Ichbinjoe/toaster-reflow/README.md

# Toaster Reflow

This board is a Raspberry Pi hat designed to be hooked up to a toaster oven to
reflow circuit boards. This board features:

+ AC Relay for turning on and off the toaster oven
+ Two thermocouple inputs
+ A servo connection for optional door servo
+ A buzzer for notifications
