Ichbinjoe/toaster-reflow/pt_1_5_2_5_0_h_cp.step

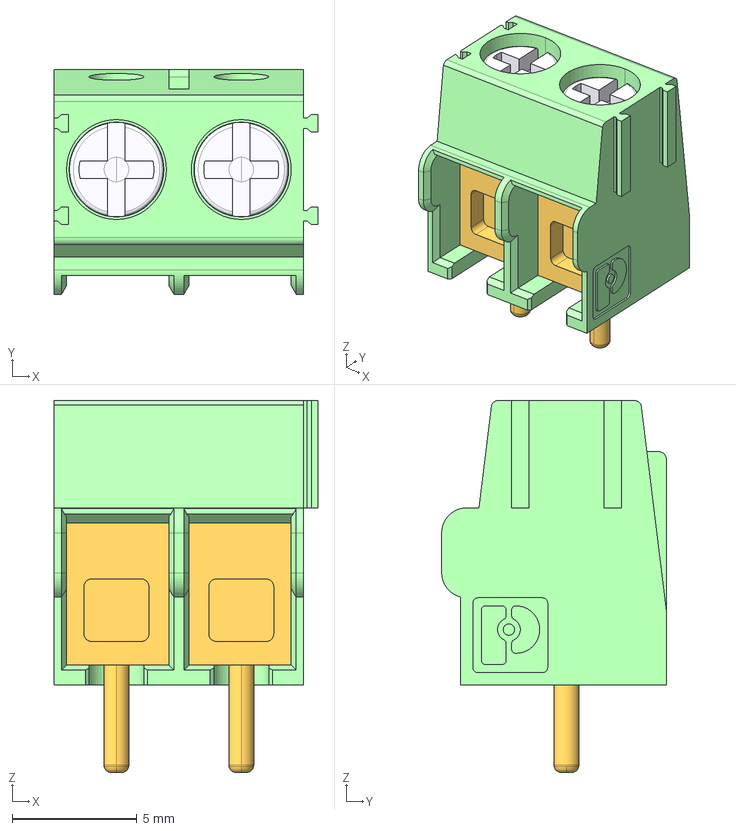
[picture p1: CAD file, 2018-09-21]
pt_1_5_2_5_0_h_cp.step
10.6 x 9.00 x 14.9 mm
