Ichbinjoe/toaster-reflow/PS12_Buzzer.step

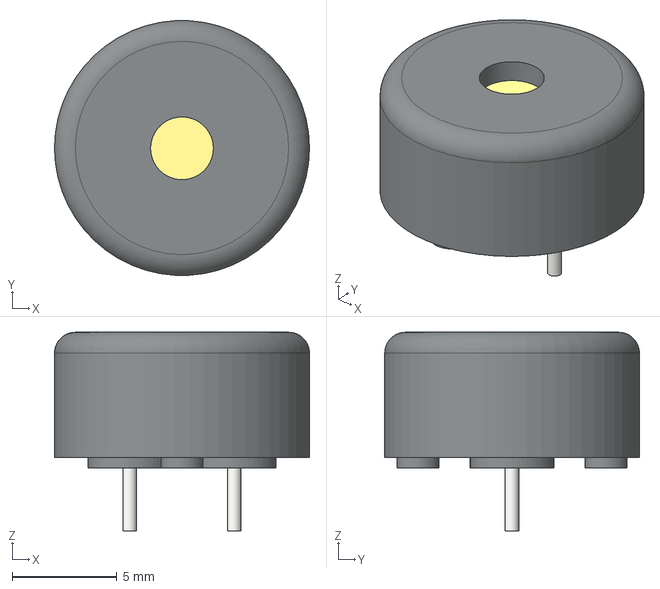
[picture p2: CAD file, 2018-09-21]
PS12_Buzzer.step
12.2 x 12.2 x 9.50 mm
