Ichbinjoe/toaster-reflow/ptsa_0_5_4_2_5_z_cp.step

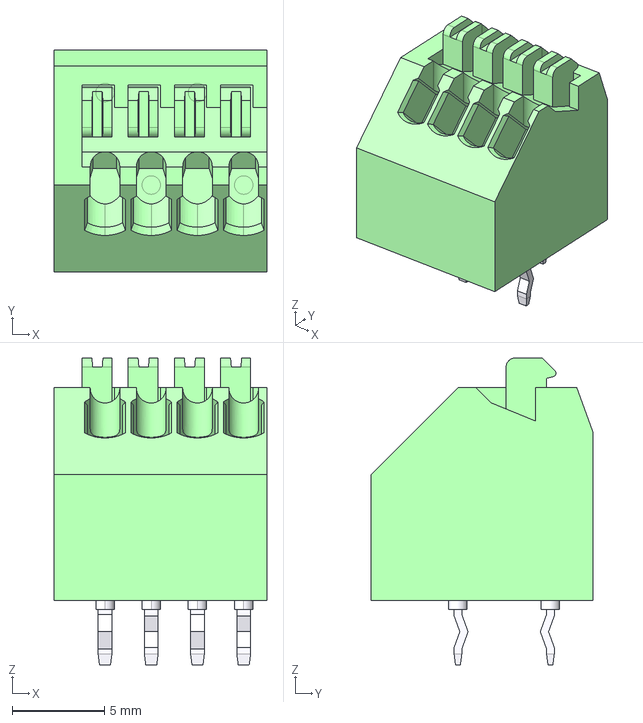
[picture p3: CAD file, 2018-09-21]
ptsa_0_5_4_2_5_z_cp.step
11.5 x 12.0 x 16.6 mm
