Ichbinjoe/toaster-reflow/C-1-1415899-3.step

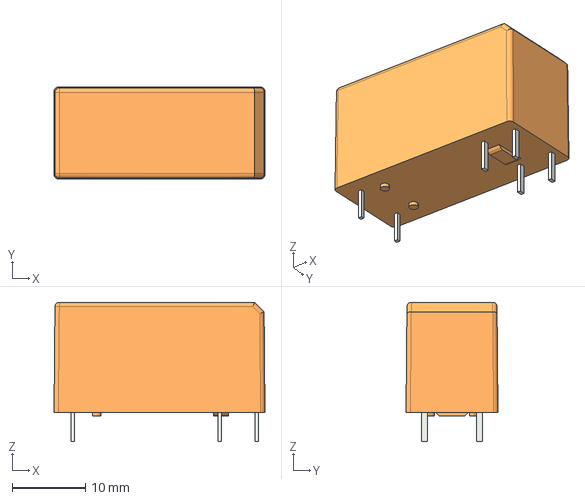
[picture p4: CAD file, 2018-09-21]
C-1-1415899-3.step
28.9 x 12.6 x 19.1 mm
