Ichbinjoe/toaster-reflow/toaster-reflow.kicad_pcb

## KiCad design toaster-reflow.kicad_pcb (2018-11-07)

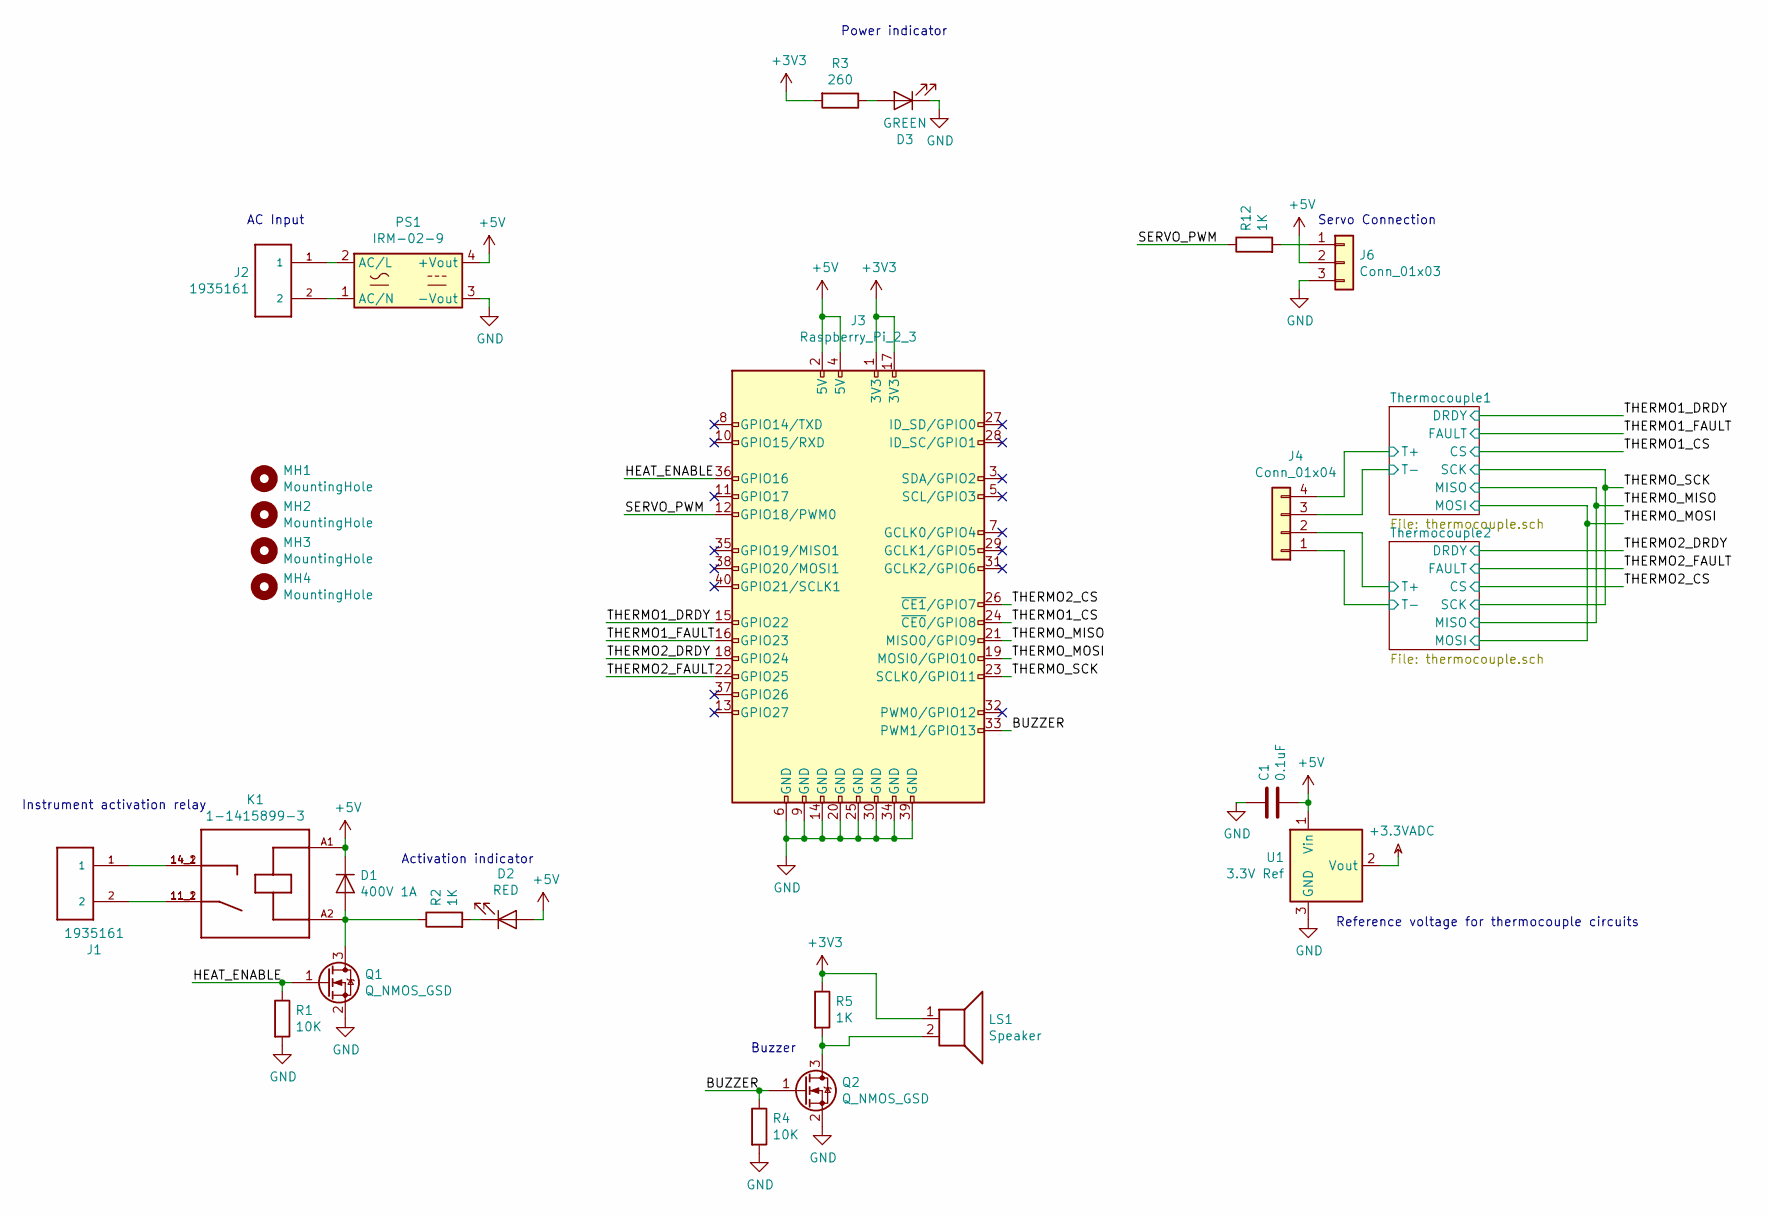
[picture p5: schematic toaster-reflow.sch]

Parts:
C1: 0.1uF; C_0603_1608Metric; DigikeyPartNumber 1276-1258-1-ND
D1: 400V 1A; D_SMA; DigikeyPartNumber 1655-1504-1-ND
D2: RED; D_0603_1608Metric; DigikeyPartNumber 732-4978-1-ND
D3: GREEN; D_0603_1608Metric; DigikeyPartNumber 732-4980-1-ND
J1, J2: 1935161; PHOENIX_1935161; DigikeyPartNumber 277-1667-ND
J3: Raspberry_Pi_2_3; PinHeader_2x20_P2.54mm_Vertical; DigikeyPartNumber S9200-ND
J4: Conn_01x04; 1990025; DigikeyPartNumber 277-1796-ND
J6: Conn_01x03; PinSocket_1x03_P2.54mm_Vertical; DigikeyPartNumber 732-5316-ND
K1: 1-1415899-3; RELAY_1-1415899-3; DigikeyPartNumber PB1267-ND
LS1: Speaker; PS12; DigikeyPartNumber 445-2525-1-ND
MH1, MH2, MH3, MH4: MountingHole; MountingHole_2.7mm_M2.5; DigikeyPartNumber 732-12923-ND
PS1: IRM-02-9; IRM-15-5; DigikeyPartNumber 1866-3037-ND
Q1, Q2: Q_NMOS_GSD; SC-59; DigikeyPartNumber RK7002BMT116CT-ND
R1, R4: 10K; R_0603_1608Metric; DigikeyPartNumber P10KGCT-ND
R2, R5, R12: 1K; R_0603_1608Metric; DigikeyPartNumber RHM1.0KDCT-ND
R3: 260; R_0603_1608Metric; DigikeyPartNumber P261HCT-ND
U1: 3.3V Ref; SOT-23; DigikeyPartNumber NCP51460SN33T1GOSCT-ND

Connections:
+3.3VADC: U1.2 (Vout); also elsewhere on the board
+3V3: J3.1 (3V3), J3.17 (3V3), LS1.1, R3.2, R5.1; also elsewhere on the board
+5V: C1.2, D1.1 (K), D2.2 (A), J3.2 (5V), J3.4 (5V), J6.2, K1.A1 (A2), PS1.4 (+Vout), U1.1 (Vin)
/BUZZER: J3.33 (PWM1/GPIO13), Q2.1 (G), R4.1
/HEAT_ENABLE: J3.36 (GPIO16), Q1.1 (G), R1.1
/SERVO_PWM: J3.12 (GPIO18/PWM0), R12.1
/THERMO1_CS: J3.24 (~CE0~/GPIO8); also elsewhere on the board
/THERMO1_DRDY: J3.15 (GPIO22); also elsewhere on the board
/THERMO1_FAULT: J3.16 (GPIO23); also elsewhere on the board
/THERMO2_CS: J3.26 (~CE1~/GPIO7); also elsewhere on the board
/THERMO2_DRDY: J3.18 (GPIO24); also elsewhere on the board
/THERMO2_FAULT: J3.22 (GPIO25); also elsewhere on the board
/THERMO_MISO: J3.21 (MISO0/GPIO9); also elsewhere on the board
/THERMO_MOSI: J3.19 (MOSI0/GPIO10); also elsewhere on the board
/THERMO_SCK: J3.23 (SCLK0/GPIO11); also elsewhere on the board
/Thermocouple1/T+: J4.4; also elsewhere on the board
/Thermocouple1/T-: J4.3; also elsewhere on the board
/Thermocouple2/T+: J4.2; also elsewhere on the board
/Thermocouple2/T-: J4.1; also elsewhere on the board
GND: C1.1, D3.1 (K), J3.6 (GND), J3.9 (GND), J3.14 (GND), J3.20 (GND), J3.25 (GND), J3.30 (GND), J3.34 (GND), J3.39 (GND), J6.3, PS1.3 (-Vout), Q1.2 (S), Q2.2 (S), R1.2, R4.2, U1.3 (GND); also elsewhere on the board
unnamed: D1.2 (A), K1.A2 (A1), Q1.3 (D), R2.1
unnamed: D2.1 (K), R2.2
unnamed: D3.2 (A), R3.1
unnamed: J1.1, K1.14_1 (14), K1.14_2 (14)
unnamed: J1.2, K1.11_1 (11), K1.11_2 (11)
unnamed: J2.1, PS1.2 (AC/L)
unnamed: J2.2, PS1.1 (AC/N)
unnamed: J6.1, R12.2
unnamed: LS1.2, Q2.3 (D), R5.2

Notes on the sheet:
Power indicator
Activation indicator
Instrument activation relay
Servo Connection
Reference voltage for thermocouple circuits
Buzzer
AC Input

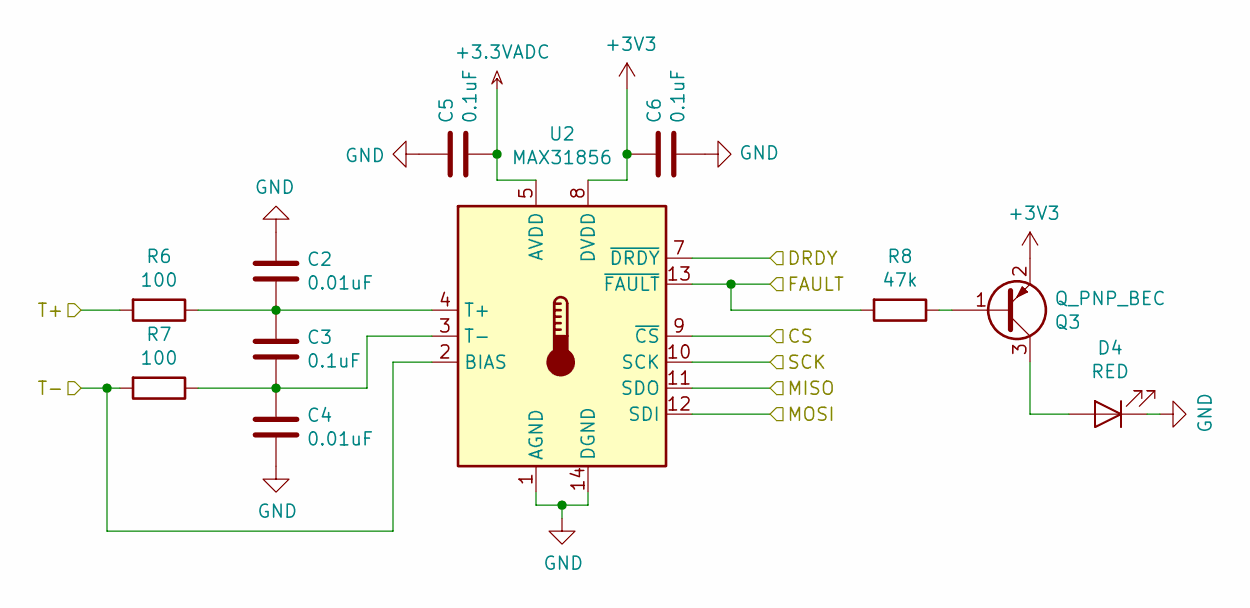
[picture p6: schematic thermocouple.sch]

Parts:
C2, C4: 0.01uF; C_0603_1608Metric; DigikeyPartNumber 1276-1921-1-ND
C3, C5, C6: 0.1uF; C_0603_1608Metric; DigikeyPartNumber 1276-1258-1-ND
D4: RED; D_0603_1608Metric; DigikeyPartNumber 732-4978-1-ND
Q3: Q_PNP_BEC; SC-59; DigikeyPartNumber MMBT3906-FDICT-ND
R6, R7: 100; R_0603_1608Metric; DigikeyPartNumber P100HCT-ND
R8: 47k; R_0603_1608Metric; DigikeyPartNumber P47.0KHCT-ND
U2: MAX31856; TSSOP-14_4.4x5mm_P0.65mm; DigikeyPartNumber MAX31856MUD+-ND

Connections:
+3.3VADC: C5.2, U2.5 (AVDD); also elsewhere on the board
+3V3: C6.1, Q3.2 (E), U2.8 (DVDD); also elsewhere on the board
/THERMO1_CS: U2.9 (~CS); also elsewhere on the board
/THERMO1_DRDY: U2.7 (~DRDY); also elsewhere on the board
/THERMO1_FAULT: R8.2, U2.13 (~FAULT); also elsewhere on the board
/THERMO_MISO: U2.11 (SDO); also elsewhere on the board
/THERMO_MOSI: U2.12 (SDI); also elsewhere on the board
/THERMO_SCK: U2.10 (SCK); also elsewhere on the board
/Thermocouple1/T+: R6.2; also elsewhere on the board
/Thermocouple1/T-: R7.2, U2.2 (BIAS); also elsewhere on the board
GND: C2.1, C4.2, C5.1, C6.2, D4.1 (K), U2.1 (AGND), U2.14 (DGND); also elsewhere on the board
unnamed: C2.2, C3.1, R6.1, U2.4 (T+)
unnamed: C3.2, C4.1, R7.1, U2.3 (T-)
unnamed: D4.2 (A), Q3.3 (C)
unnamed: Q3.1 (B), R8.1

Parts of its further copies:
C7, C9: 0.01uF; C_0603_1608Metric; DigikeyPartNumber 1276-1921-1-ND
C8, C10, C11: 0.1uF; C_0603_1608Metric; DigikeyPartNumber 1276-1258-1-ND
D5: RED; D_0603_1608Metric; DigikeyPartNumber 732-4978-1-ND
Q4: Q_PNP_BEC; SC-59; DigikeyPartNumber MMBT3906-FDICT-ND
R9, R10: 100; R_0603_1608Metric; DigikeyPartNumber P100HCT-ND
R11: 47k; R_0603_1608Metric; DigikeyPartNumber P47.0KHCT-ND
U3: MAX31856; TSSOP-14_4.4x5mm_P0.65mm; DigikeyPartNumber MAX31856MUD+-ND

Connections of its further copies:
+3.3VADC: C10.2, U3.5 (AVDD); also elsewhere on the board
+3V3: C11.1, Q4.2 (E), U3.8 (DVDD); also elsewhere on the board
/THERMO2_CS: U3.9 (~CS); also elsewhere on the board
/THERMO2_DRDY: U3.7 (~DRDY); also elsewhere on the board
/THERMO2_FAULT: R11.2, U3.13 (~FAULT); also elsewhere on the board
/THERMO_MISO: U3.11 (SDO); also elsewhere on the board
/THERMO_MOSI: U3.12 (SDI); also elsewhere on the board
/THERMO_SCK: U3.10 (SCK); also elsewhere on the board
/Thermocouple2/T+: R9.2; also elsewhere on the board
/Thermocouple2/T-: R10.2, U3.2 (BIAS); also elsewhere on the board
GND: C7.1, C9.2, C10.1, C11.2, D5.1 (K), U3.1 (AGND), U3.14 (DGND); also elsewhere on the board
unnamed: C7.2, C8.1, R9.1, U3.4 (T+)
unnamed: C8.2, C9.1, R10.1, U3.3 (T-)
unnamed: D5.2 (A), Q4.3 (C)
unnamed: Q4.1 (B), R11.1

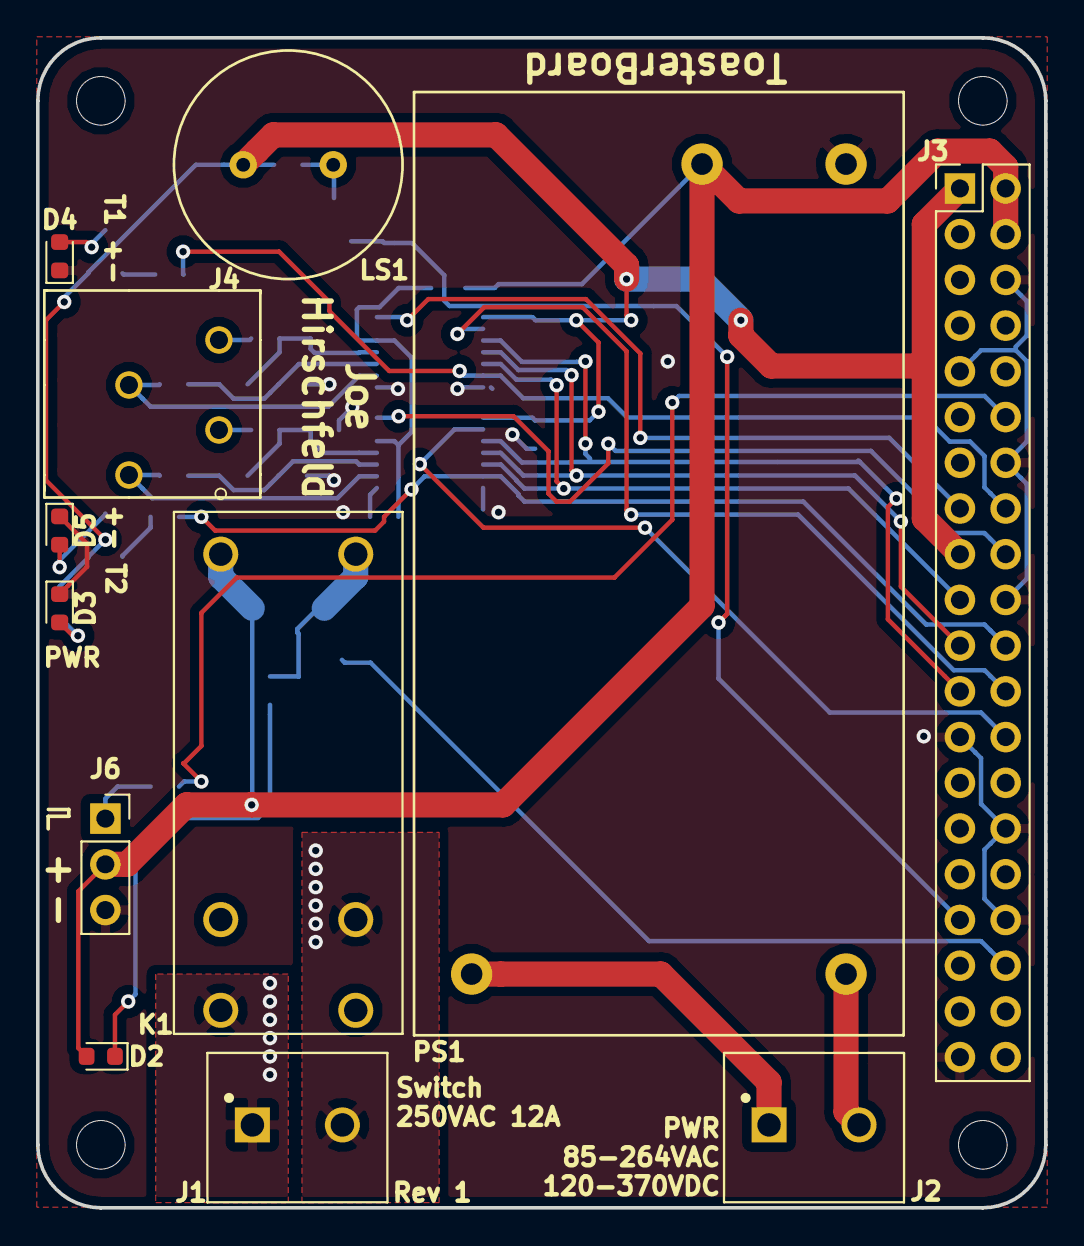
[picture p7: board toaster-reflow.kicad_pcb from above]

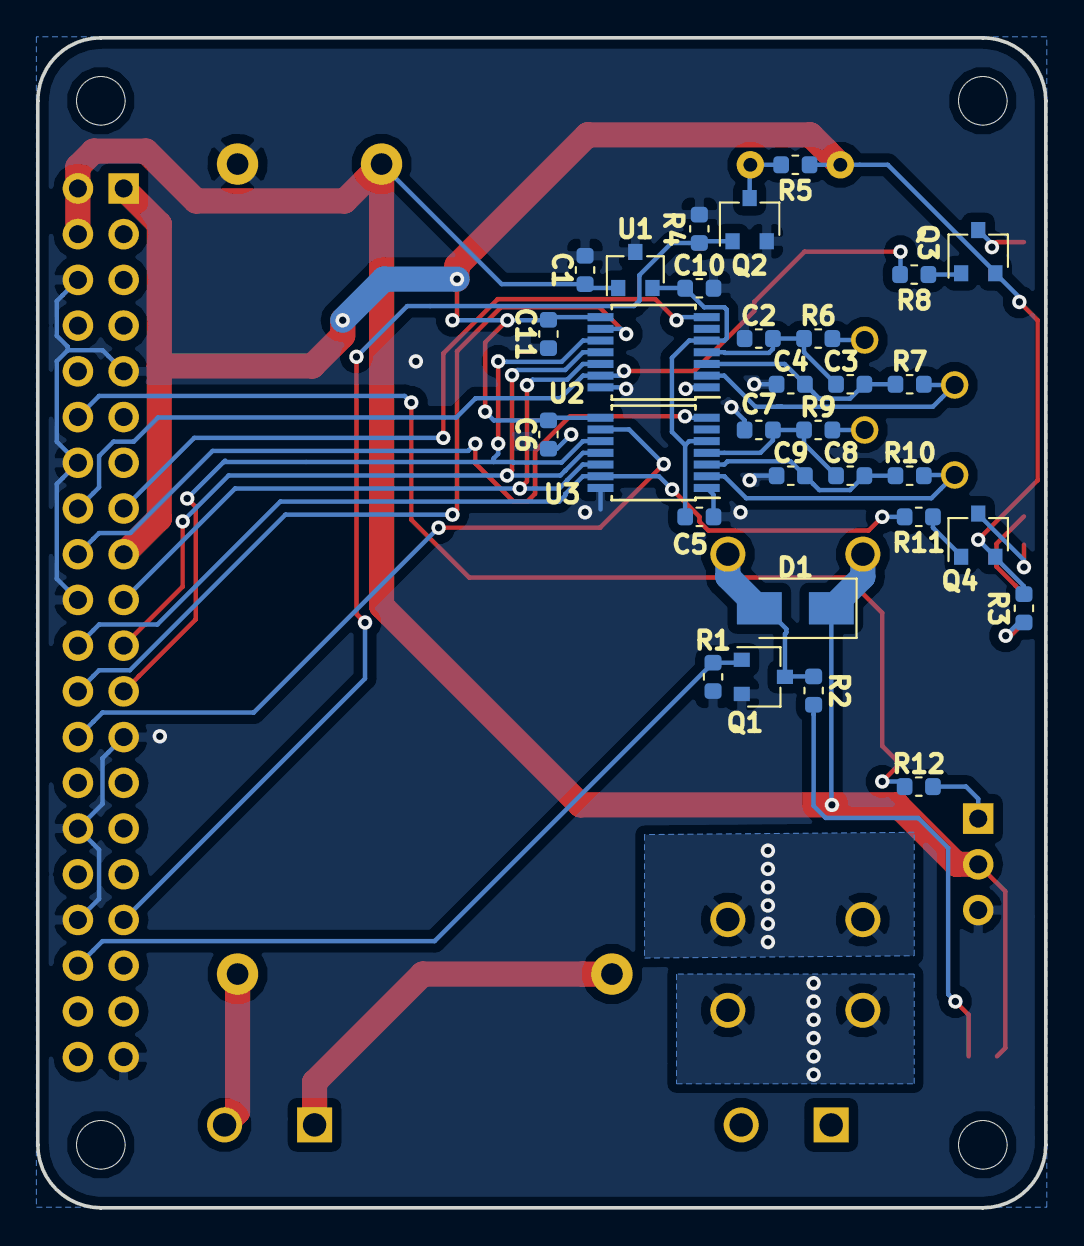
[picture p8: board toaster-reflow.kicad_pcb from below]

Board: 2 copper layers, 56.0 x 65.0 mm, 47 parts (31 on the bottom side), 37 nets.
