Ichbinjoe/toaster-reflow/toaster-reflowv1.kicad_pcb

## KiCad design toaster-reflowv1.kicad_pcb (2018-09-20)

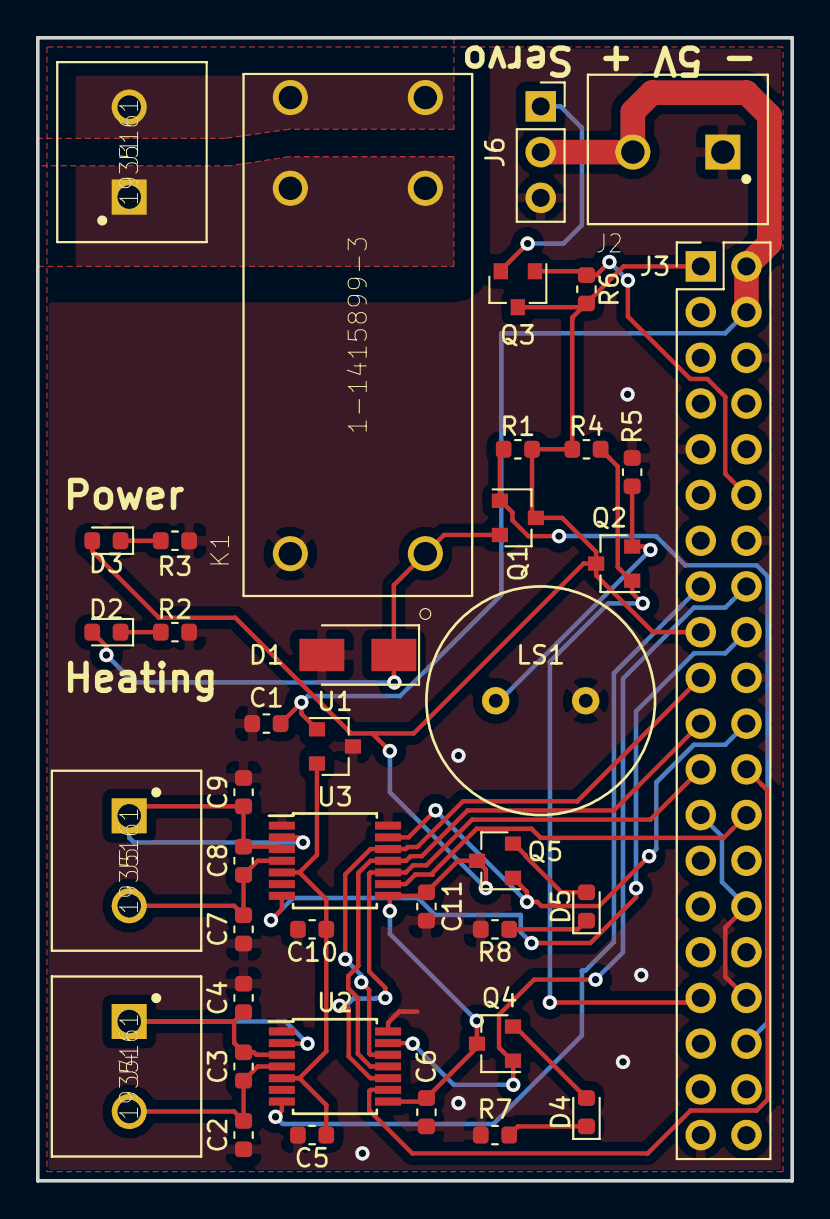
[picture p9: board toaster-reflowv1.kicad_pcb from above]

Board: 2 copper layers, 41.9 x 63.5 mm, 40 parts (0 on the bottom side), 31 nets.

Parts:
C1, C3, C5, C6, C8, C10, C11: 0.1uF; C_0603_1608Metric
C2, C4, C7, C9: 0.01uF; C_0603_1608Metric
D1: 400V 1A; D_SMA
D2, D4, D5: RED; D_0603_1608Metric
D3: GREEN; D_0603_1608Metric
J1, J2, J4, J5: 1935161; PHOENIX_1935161
J3: Raspberry_Pi_2_3; PinHeader_2x20_P2.54mm_Vertical
J6: Conn_01x03; PinSocket_1x03_P2.54mm_Vertical
K1: 1-1415899-3; RELAY_1-1415899-3
LS1: Speaker; PS12
Q1, Q2, Q3, Q4, Q5: Q_PMOS_GSD; SOT-23
R1, R4, R6: 10K; R_0603_1608Metric
R2, R7, R8: 470; R_0603_1608Metric
R3: 260; R_0603_1608Metric
R5: 1K; R_0603_1608Metric
U1: 3.3V Ref; SOT-23
U2, U3: MAX31856; TSSOP-14_4.4x5mm_P0.65mm

Connections:
+3.3VADC: C5.2, C10.2, U1.2, U2.5, U3.5
+3V3: C6.1, C11.1, D3.2, J3.1, J3.17, Q1.3, Q2.3, Q3.3, Q4.3, Q5.3, R1.1, R4.1, R6.1, U2.8, U3.8
+5V: C1.2, J2.2, J3.2, J3.4, J6.2, U1.1
/BUZZER: J3.33, Q2.1, R4.2
/HEAT_ENABLE: J3.36, Q1.1, R1.2
/SERVO_PWM: J3.12, Q3.1, R6.2
/THERMO1_CS: J3.24, U2.9
/THERMO1_DRDY: J3.15, U2.7
/THERMO1_FAULT: J3.16, Q4.1, U2.13
/THERMO2_CS: J3.26, U3.9
/THERMO2_DRDY: J3.18, U3.7
/THERMO2_FAULT: J3.22, Q5.1, U3.13
/THERMO_MISO: J3.21, U2.11, U3.11
/THERMO_MOSI: J3.19, U2.12, U3.12
/THERMO_SCK: J3.23, U2.10, U3.10
GND: C1.1, C2.1, C4.2, C5.1, C6.2, C7.1, C9.2, C10.1, C11.2, D1.2, J2.1, J3.6, J3.9, J3.14, J3.20, J3.25, J3.30, J3.34, J3.39, J6.3, K1.A2, LS1.2, R2.1, R3.1, R5.2, R7.1, R8.1, U1.3, U2.1, U2.14, U3.1, U3.14
unnamed: C2.2, C3.1, J4.2, U2.4
unnamed: C3.2, C4.1, J4.1, U2.2, U2.3
unnamed: C7.2, C8.1, J5.2, U3.4
unnamed: C8.2, C9.1, J5.1, U3.2, U3.3
unnamed: D1.1, D2.2, K1.A1, Q1.2
unnamed: D2.1, R2.2
unnamed: D3.1, R3.2
unnamed: D4.1, R7.2
unnamed: D4.2, Q4.2
unnamed: D5.1, R8.2
unnamed: D5.2, Q5.2
unnamed: J1.1, K1.11_1, K1.11_2
unnamed: J1.2, K1.14_1, K1.14_2
unnamed: J6.1, Q3.2
unnamed: LS1.1, Q2.2, R5.1
