Ichbinjoe/toaster-reflow/(commit log)

2018-08-31 Add bom wizard, fix 'duplicate' part
    [toaster-reflow.sch]
2018-09-01 Use better MAX31856, fill in some parts
    [thermocouple.sch, toaster-reflow.sch]
2018-09-01 Add pcb, update packages
    [thermocouple.sch, toaster-reflow.kicad_pcb, toaster-reflow.sch]
2018-09-01 Forgot a footprint! Created components on board
    [toaster-reflow.kicad_pcb, toaster-reflow.sch]
2018-09-01 Finish pcb routing
    [toaster-reflow.kicad_pcb]
2018-09-01 move some silkscreen items
    [toaster-reflow.kicad_pcb]
2018-09-20 update pcb
    [toaster-reflow.kicad_pcb]
2018-09-21 Add a bunch of stuff
    [C-1-1415899-3.step, PS12_Buzzer.step, pt_1_5_2_5_0_h_cp.step, ptsa_0_5_4_2_5_z_cp.step, thermocouple.sch, toaster-reflow.kicad_pcb, toaster-reflow.sch, toaster-reflowv1.kicad_pcb]
2018-09-21 update pcb for 3d rendering
    [toaster-reflow.kicad_pcb]
2018-10-11 UPdate transistor wiring
    [thermocouple.sch, toaster-reflow.kicad_pcb]
2018-11-06 update some stuff
    [thermocouple.sch, toaster-reflow.kicad_pcb, toaster-reflow.sch]
2018-11-06 new design/ layout
    [thermocouple.sch, toaster-reflow.kicad_pcb, toaster-reflow.sch]
2018-11-07 update some silkscreening
    [toaster-reflow.kicad_pcb]
2018-11-07 send out for fabrication
    [thermocouple.sch, toaster-reflow.kicad_pcb]
